Xevel/dynext/README.md

dynext
======

Dynamixel extension board.
