Xevel/dynext/hardware/README.txt

Dynext - universal dynamixel device
===================================

V1.0 - 2014/03/02
- 4 layers
- first manufactured board
- smaller power section
- added voltage ref
- cleaner separation of different voltages, and corresponding return path

v0.2 - unfinished, was too hard to route in 2 layers. The power section was nice though.

v0.1 - unfinished, was too hard to route in 2 layers
