Xevel/dynext/hardware/dynext_v2.1.brd

## EAGLE design hardware/dynext_v2.1.brd (2014-04-13)

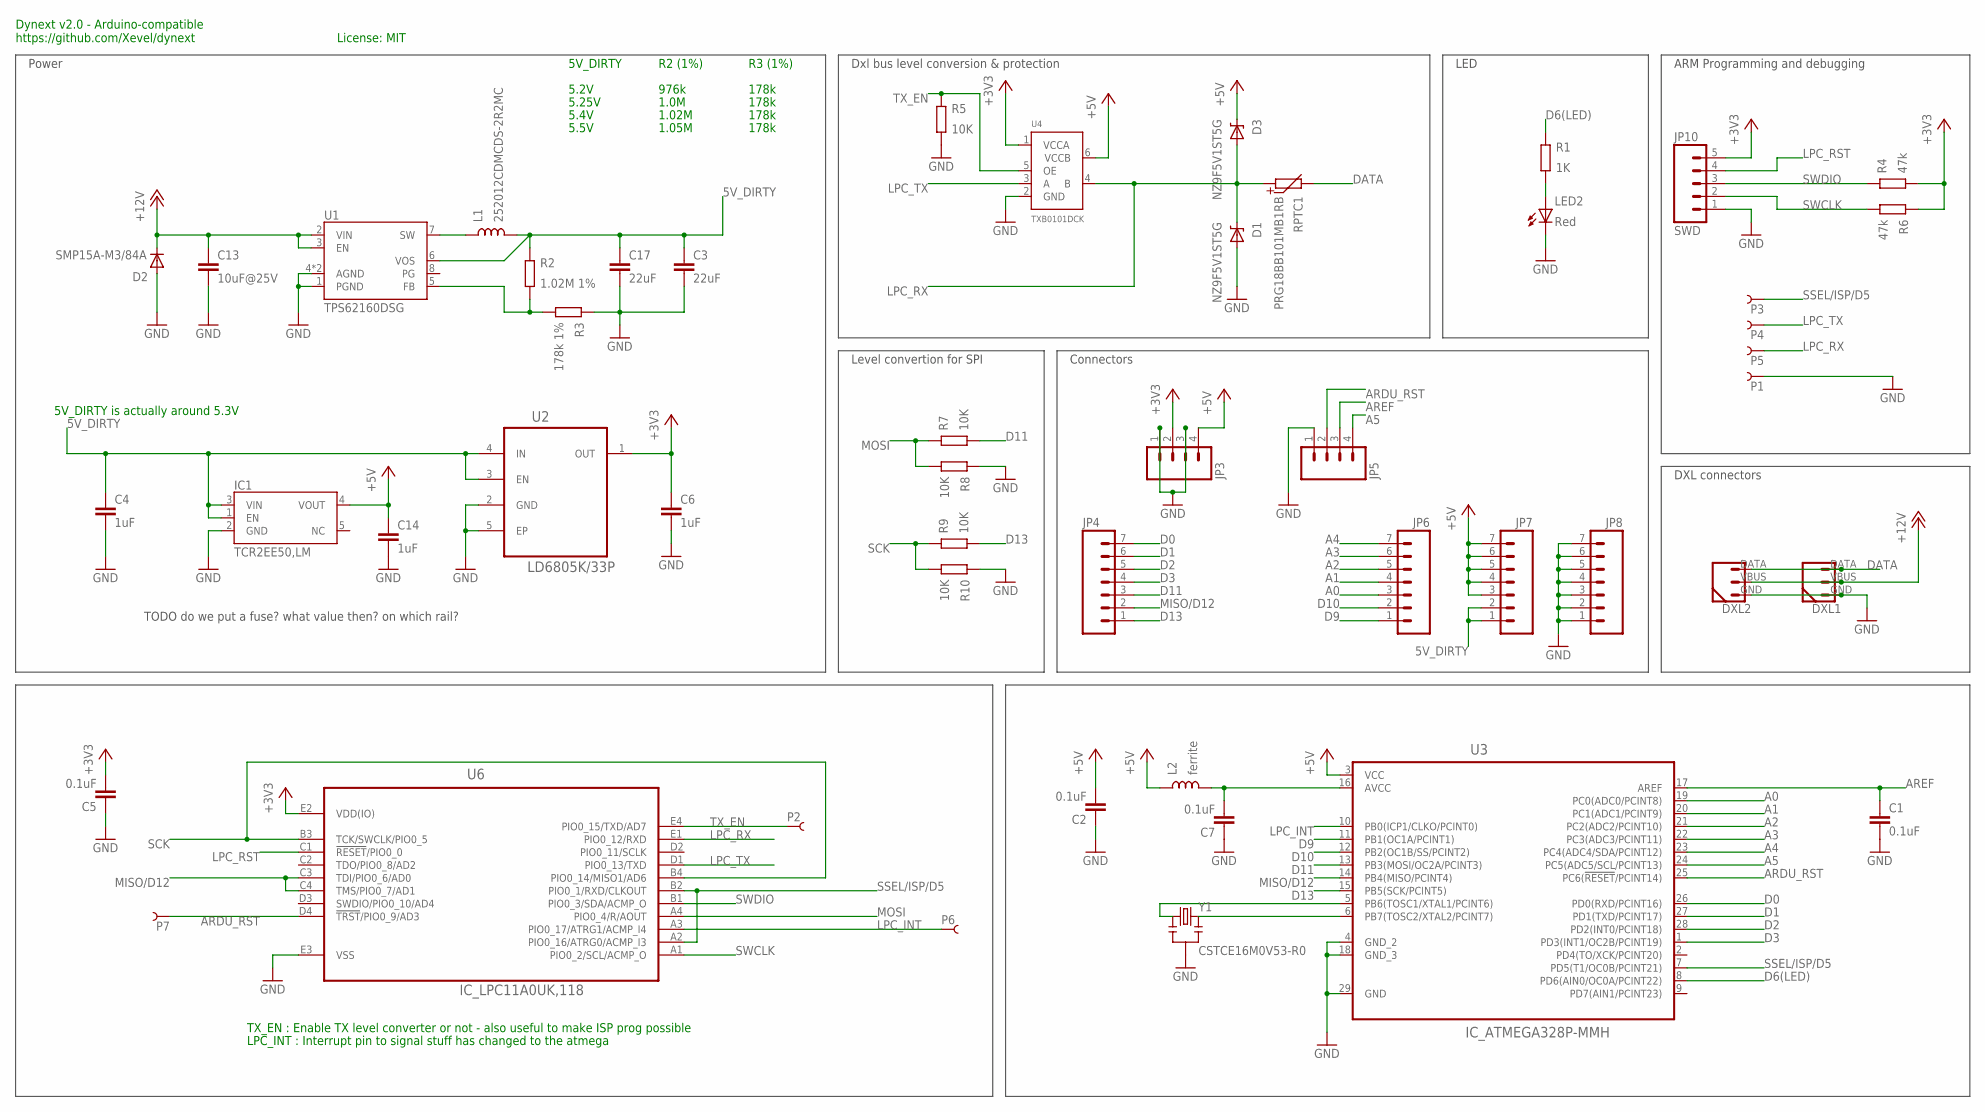
[picture p1: schematic dynext_v2.1.sch]

Parts:
C1, C2, C5, C7: 0.1uF; 0201_N
C3, C17: 22uF; 1206_N
C4, C6, C14: 1uF; 0402_N
C13: 10uF@25V; 0805_N
D1, D3: NZ9F5V1ST5G; SOD-923_N
D2: SMP15A-M3/84A; DO-220AA
DXL1, DXL2: DYNAMIXEL_3POS-R; DYNAMIXEL_3POS_RIGHT
IC1: TCR2EE50,LM; SOT50P160X60-5N
JP3, JP5: M041X04_NO_SILK; 1X04_NO_SILK
JP4, JP6, JP7: M07NO_SILK; 1X07_NO_SILK
JP8: M07SQUARE_ALL; 1X07_SQUARE_ALL
JP10: SWD; 1X05-1.27MM
L1: 252012CDMCDS-2R2MC; 1008_N
L2: ferrite; 0402_N
LED2: Red; D_0603_N
P1, P3, P4, P5: PIN_SMD_0.8X2
P2, P6, P7: PIN_SMD_1X1
R1: 1K; 0201_N
R2: 1.02M 1%; 0201_N
R3: 178k 1%; 0201_N
R4, R6: 47k; 0201_N
R5, R7, R8, R9, R10: 10K; 0201_N
RPTC1: PRG18BB101MB1RB; 0603_N
U1: TPS62160DSG; SON50P200X200X80-9L
U2: LD6805K/33P; NXP_LD6805
U3: IC_ATMEGA328P-MMH; QFN45P400X400X100-29N
U4: TXB0101DCK; SC70-6
U6: IC_LPC11A0UK,118; BGA20C50P_250X250X65
Y1: CSTCE16M0V53-R0; RESONATOR-SMD

Connections:
5V_DIRTY: C3.1, C4.1, C17.1, IC1.1 (EN), IC1.3 (VIN), JP7.1, JP7.2, L1.2, R2.2, U1.6 (VOS), U2.3 (EN), U2.4 (IN)
+3V3: C5.2, C6.1, JP3.2, JP10.5, R4.1, R6.2, U2.1 (OUT), U4.1 (VCCA), U6.E2 (VDD(IO))
+5V: C2.2, C14.1, D3.C, IC1.4 (VOUT), JP3.4, JP7.3, JP7.4, JP7.5, JP7.6, JP7.7, L2.1, U3.3 (VCC), U4.6 (VCCB)
+12V: C13.1, D2.C, DXL1.VBUS (2), DXL2.VBUS (2), U1.2 (VIN), U1.3 (EN)
A0: JP6.3, U3.19 (PC0(ADC0/PCINT8))
A1: JP6.4, U3.20 (PC1(ADC1/PCINT9))
A2: JP6.5, U3.21 (PC2(ADC2/PCINT10))
A3: JP6.6, U3.22 (PC3(ADC3/PCINT11))
A4: JP6.7, U3.23 (PC4(ADC4/SDA/PCINT12))
A5: JP5.4, U3.24 (PC5(ADC5/SCL/PCINT13))
ARDU_RST: JP5.2, P7.P$1, U3.25 (PC6(!RESET!/PCINT14)), U6.D4 (!TRST!/PIO0_9/AD3)
AREF: C1.1, JP5.3, U3.17 (AREF)
AVCC: C7.2, L2.2, U3.16 (AVCC)
D0: JP4.7, U3.26 (PD0(RXD/PCINT16))
D1: JP4.6, U3.27 (PD1(TXD/PCINT17))
D2: JP4.5, U3.28 (PD2(INT0/PCINT18))
D3: JP4.4, U3.1 (PD3(INT1/OC2B/PCINT19))
D6(LED): R1.2, U3.8 (PD6(AIN0/OC0A/PCINT22))
D9: JP6.1, U3.11 (PB1(OC1A/PCINT1))
D10: JP6.2, U3.12 (PB2(OC1B/SS/PCINT2))
D11: JP4.3, R7.1, U3.13 (PB3(MOSI/OC2A/PCINT3))
D13: JP4.1, R9.1, U3.15 (PB5(SCK/PCINT5))
DATA: DXL1.DATA (3), DXL2.DATA (3), RPTC1.2
GND: C1.2, C2.1, C3.2, C4.2, C5.1, C6.2, C7.1, C13.2, C14.2, C17.2, D1.A, D2.A, DXL1.GND (1), DXL2.GND (1), IC1.2 (GND), JP3.1, JP3.3, JP5.1, JP8.1, JP8.2, JP8.3, JP8.4, JP8.5, JP8.6, JP8.7, JP10.1, LED2.C, P1.PIN, R3.2, R5.1, R8.2, R10.2, U1.1 (PGND), U1.4 (AGND), U1.9 (AGND), U2.2 (GND), U2.5 (EP), U3.4 (GND_2), U3.18 (GND_3), U3.29 (GND), U4.2 (GND), U6.E3 (VSS), Y1.2
LPC_INT: P6.P$1, U3.10 (PB0(ICP1/CLKO/PCINT0)), U6.A3 (PIO0_17/ATRG1/ACMP_I4)
LPC_RST: JP10.4, U6.C1 (!RESET!/PIO0_0)
LPC_RX: D1.C, D3.A, P5.PIN, RPTC1.1, U4.4 (B), U6.E1 (PIO0_12/RXD)
LPC_TX: P4.PIN, U4.3 (A), U6.D1 (PIO0_13/TXD)
MISO/D12: JP4.2, U3.14 (PB4(MISO/PCINT4)), U6.C3 (TDI/PIO0_6/AD0), U6.C4 (TMS/PIO0_7/AD1)
MOSI: R7.2, R8.1, U6.A4 (PIO0_4/R/AOUT)
unnamed: L1.1, U1.7 (SW)
unnamed: LED2.A, R1.1
unnamed: U3.5 (PB6(TOSC1/XTAL1/PCINT6)), Y1.1
unnamed: U3.6 (PB7(TOSC2/XTAL2/PCINT7)), Y1.3
unnamed: R2.1, R3.1, U1.5 (FB)
SCK: R9.2, R10.1, U6.B3 (TCK/SWCLK/PIO0_5), U6.B4 (PIO0_14/MISO1/AD6)
SSEL/ISP/D5: P3.PIN, U3.7 (PD5(T1/OC0B/PCINT21)), U6.A2 (PIO0_16/ATRG0/ACMP_I3), U6.B2 (PIO0_1/RXD/CLKOUT)
SWCLK: JP10.2, R6.1, U6.A1 (PIO0_2/SCL/ACMP_O)
SWDIO: JP10.3, R4.2, U6.B1 (PIO0_3/SDA/ACMP_O)
TX_EN: P2.P$1, R5.2, U4.5 (OE), U6.E4 (PIO0_15/TXD/AD7)

Notes on the sheet:
DXL connectors
Power
ARM Programming and debugging
Dxl bus level conversion & protection
LED
Connectors
Dynext v2.0 - Arduino-compatible https://github.com/Xevel/dynext
License: MIT
LPC_INT : Interrupt pin to signal stuff has changed to the atmega
TX_EN : Enable TX level converter or not - also useful to make ISP prog possible
TODO do we put a fuse? what value then? on which rail?
Level convertion for SPI
5V_DIRTY is actually around 5.3V
R2 (1%)
R3 (1%)
5.2V
5.4V
5.25V
5.5V
976k
178k
1.0M
1.02M
1.05M
5V_DIRTY

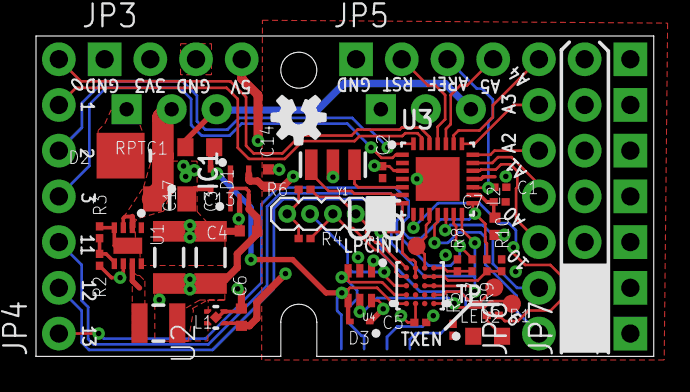
[picture p2: board dynext_v2.1.brd from above]

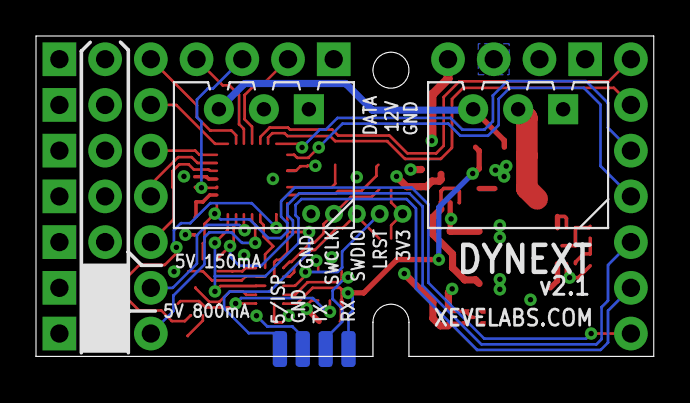
[picture p3: board dynext_v2.1.brd from below]

Board: 4 copper layers, 34.3 x 17.8 mm, 51 parts (6 on the bottom side), 40 nets.

Other parts of the board:
U$1: OSHW-LOGO-S
