Xevel/dynext/hardware/dynext_v1.1.brd

## EAGLE design hardware/dynext_v1.1.brd (2014-03-31, an earlier design)

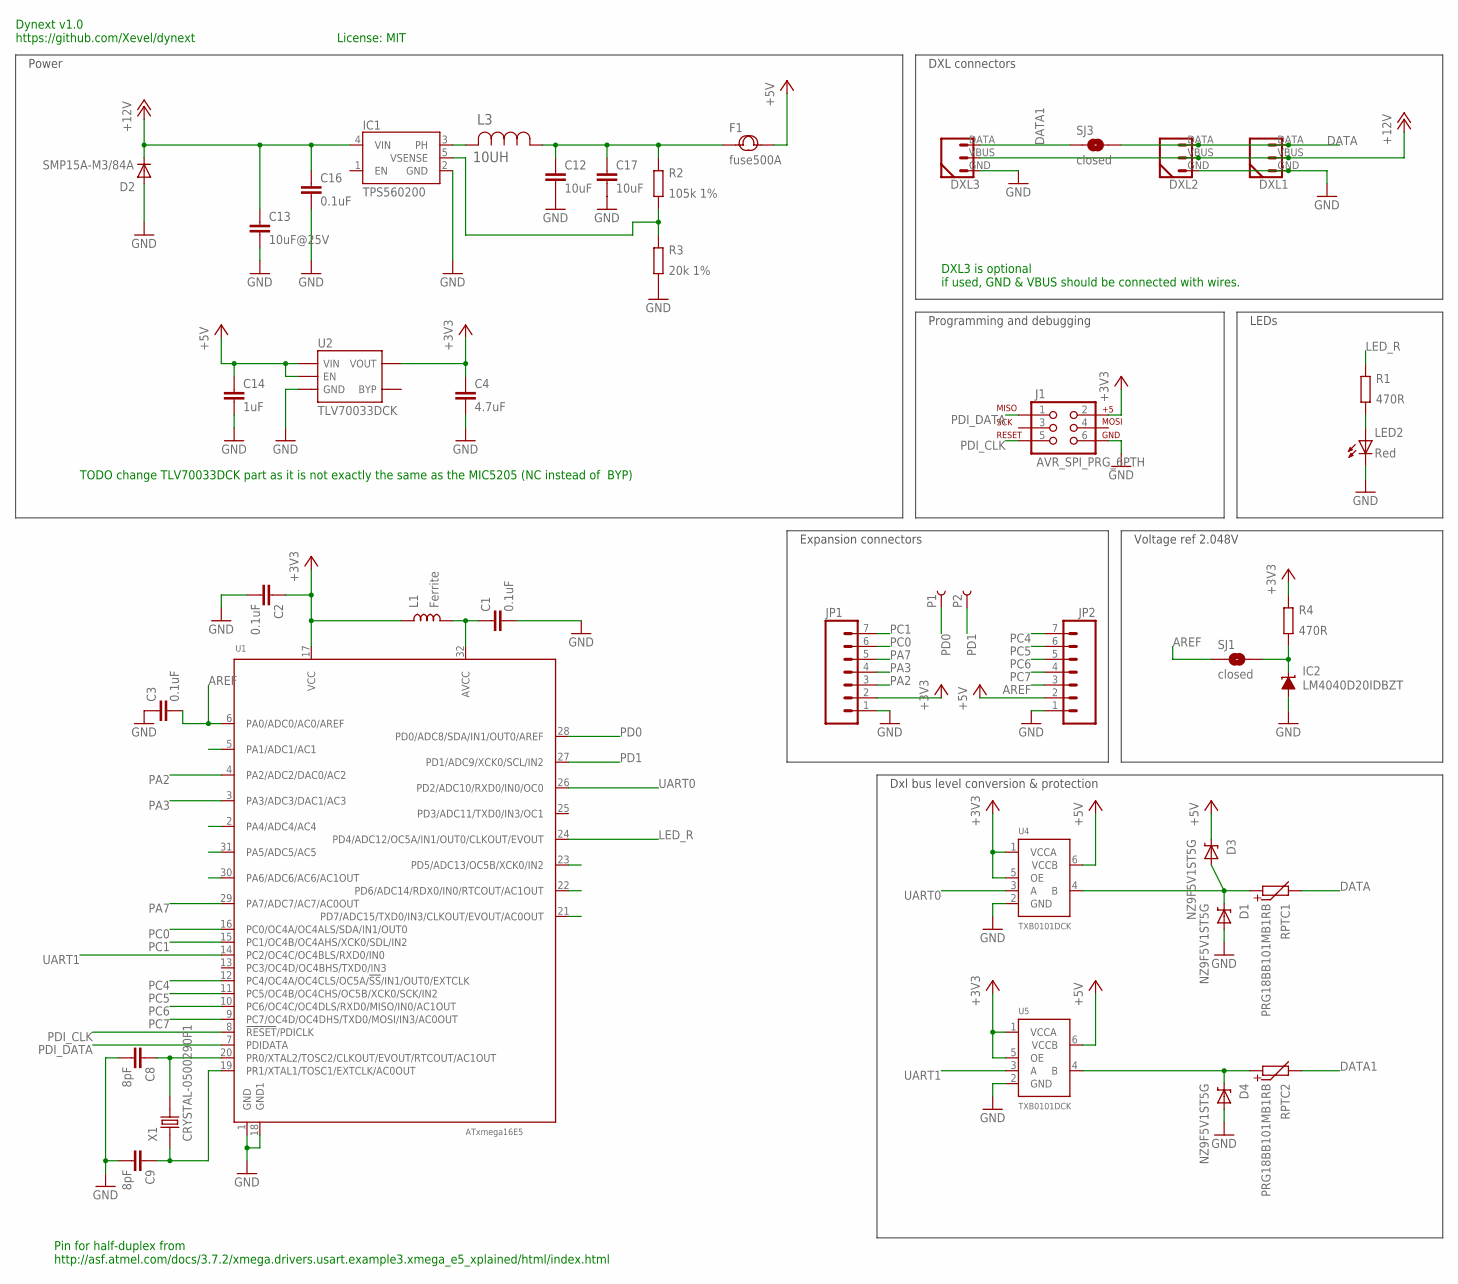
[picture p4: schematic dynext_v1.1.sch]

Parts:
C1, C2, C3, C16: 0.1uF; 0402_N
C4: 4.7uF; 0603_N
C8, C9: 8pF; 0402_N
C12, C17: 10uF; 0805_N
C13: 10uF@25V; 0805_N
C14: 1uF; 0402_N
D1, D3, D4: NZ9F5V1ST5G; SOD-923_N
D2: SMP15A-M3/84A; DO-220AA
DXL1, DXL2: DYNAMIXEL_3POS-T; DYNAMIXEL_3POS_TOP
DXL3: DYNAMIXEL_3POS-R; DYNAMIXEL_3POS_RIGHT
F1: fuse500A; F1206
IC1: TPS560200; SOT-23-5_N
IC2: LM4040D20IDBZT; DBZ_R-PDSO-G3
J1: AVR_SPI_PRG_6PTH; 2X3
JP1, JP2: M07; 1X07
L1: Ferrite; 0603_N
L3: 10UH; IND_ELL4XG
LED2: Red; D_0603_N
P1, P2: PIN_SMD_2X2.5
R1, R4: 470R; 0402_N
R2: 105k 1%; 0402_N
R3: 20k 1%; 0402_N
RPTC1, RPTC2: PRG18BB101MB1RB; 0603_N
SJ1, SJ3: closed; SJ_2S-TRACE2
U1: ATxmega16E5; QFN-32_50P_L_MOD
U2: TLV70033DCK; SC70-5
U4, U5: TXB0101DCK; SC70-6
X1: CRYSTAL-0500290P1; 2P-SMD-5.0X3.2

Connections:
+3V3: C2.1, C4.1, J1.2, JP1.2, L1.1, R4.2, U1.17 (VCC), U2.5 (VOUT), U4.1 (VCCA), U4.5 (OE), U5.1 (VCCA), U5.5 (OE)
+5V: C14.1, D3.C, F1.2, JP2.2, U2.1 (VIN), U2.3 (EN), U4.6 (VCCB), U5.6 (VCCB)
+12V: C13.1, C16.1, D2.C, DXL1.VBUS (2), DXL2.VBUS (2), DXL3.VBUS (2), IC1.4 (VIN)
AREF: C3.2, JP2.3, SJ1.1, U1.6 (PA0/ADC0/AC0/AREF)
DATA: DXL1.DATA (3), DXL2.DATA (3), RPTC1.2, SJ3.2
DATA1: DXL3.DATA (3), RPTC2.2, SJ3.1
GND: C1.2, C2.2, C3.1, C4.2, C8.2, C9.2, C12.2, C13.2, C14.2, C16.2, C17.2, D1.A, D2.A, D4.A, DXL1.GND (1), DXL2.GND (1), DXL3.GND (1), IC1.2 (GND), IC2.2 (A), J1.6, JP1.1, JP2.1, LED2.C, R3.1, U1.1 (GND), U1.18 (GND1), U2.2 (GND), U4.2 (GND), U5.2 (GND)
LED_R: R1.2, U1.24 (PD4/ADC12/OC5A/IN1/OUT0/CLKOUT/EVOUT)
unnamed: C1.1, L1.2, U1.32 (AVCC)
unnamed: LED2.A, R1.1
unnamed: C8.1, U1.20 (PR0/XTAL2/TOSC2/CLKOUT/EVOUT/RTCOUT/AC1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), X1.2
unnamed: C9.1, U1.19 (PR1/XTAL1/TOSC1/EXTCLK/AC0OUT), X1.1
unnamed: D1.C, D3.A, RPTC1.1, U4.4 (B)
unnamed: D4.C, RPTC2.1, U5.4 (B)
unnamed: C12.1, C17.1, F1.1, L3.1, R2.2
unnamed: IC1.5 (VSENSE), R2.1, R3.2
unnamed: IC2.1 (C), R4.1, SJ1.2
PA2: JP1.3, U1.4 (PA2/ADC2/DAC0/AC2)
PA3: JP1.4, U1.3 (PA3/ADC3/DAC1/AC3)
PA7: JP1.5, U1.29 (PA7/ADC7/AC7/AC0OUT)
PC0: JP1.6, U1.16 (PC0/OC4A/OC4ALS/SDA/IN1/OUT0)
PC1: JP1.7, U1.15 (PC1/OC4B/OC4AHS/XCK0/SDL/IN2)
PC4: JP2.7, U1.12 (PC4/OC4A/OC4CLS/OC5A/!SS!/IN1/OUT0/EXTC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)
PC5: JP2.6, U1.11 (PC5/OC4B/OC4CHS/OC5B/XCK0/SCK/IN2)
PC6: JP2.5, U1.10 (PC6/OC4C/OC4DLS/RXD0/MISO/IN0/AC1OUT)
PC7: JP2.4, U1.9 (PC7/OC4D/OC4DHS/TXD0/MOSI/IN3/AC0OUT)
PD0: P1.PIN, U1.28 (PD0/ADC8/SDA/IN1/OUT0/AREF)
PD1: P2.PIN, U1.27 (PD1/ADC9/XCK0/SCL/IN2)
PDI_CLK: J1.5, U1.8 (!RESET!/PDICLK)
PDI_DATA: J1.1, U1.7 (PDIDATA)
PH_L: IC1.3 (PH), L3.2
UART0: U1.26 (PD2/ADC10/RXD0/IN0/OC0), U4.3 (A)
UART1: U1.14 (PC2/OC4C/OC4BLS/RXD0/IN0), U5.3 (A)

Notes on the sheet:
DXL connectors
Power
Programming and debugging
Dxl bus level conversion & protection
LEDs
DXL3 is optional if used, GND & VBUS should be connected with wires.
Voltage ref 2.048V
TODO change TLV70033DCK part as it is not exactly the same as the MIC5205 (NC instead of BYP)
Pin for half-duplex from http://asf.atmel.com/docs/3.7.2/xmega.drivers.usart.example3.xmega_e5_xplained/html/index.html
Expansion connectors
Dynext v1.0 https://github.com/Xevel/dynext
License: MIT

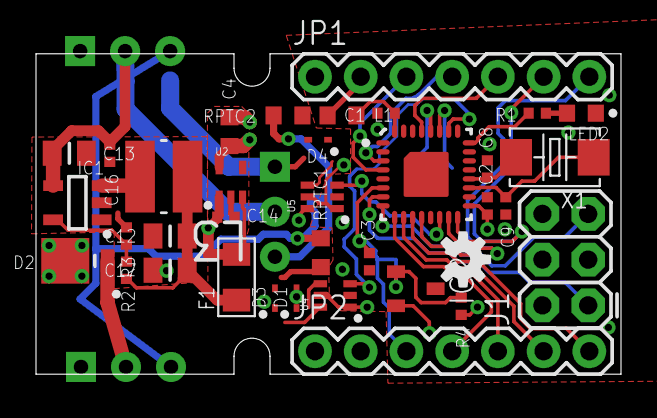
[picture p5: board dynext_v1.1.brd from above]

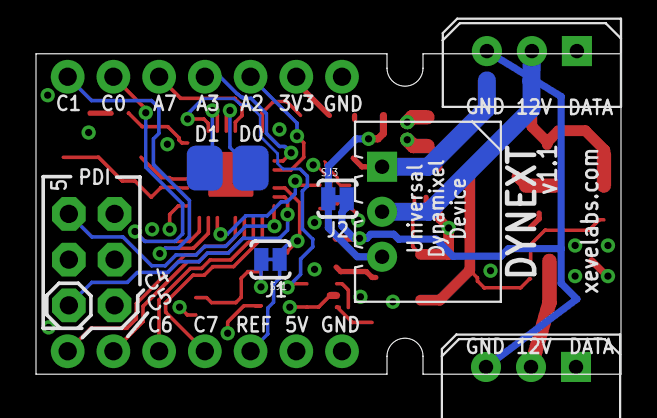
[picture p6: board dynext_v1.1.brd from below]

Board: 4 copper layers, 32.5 x 17.8 mm, 43 parts (5 on the bottom side), 33 nets.

Other parts of the board:
U$1: OSHW-LOGO-S
