Xevel/dynext/hardware/dynext_v0.1.brd

## EAGLE design hardware/dynext_v0.1.brd (2014-03-31, an earlier design)

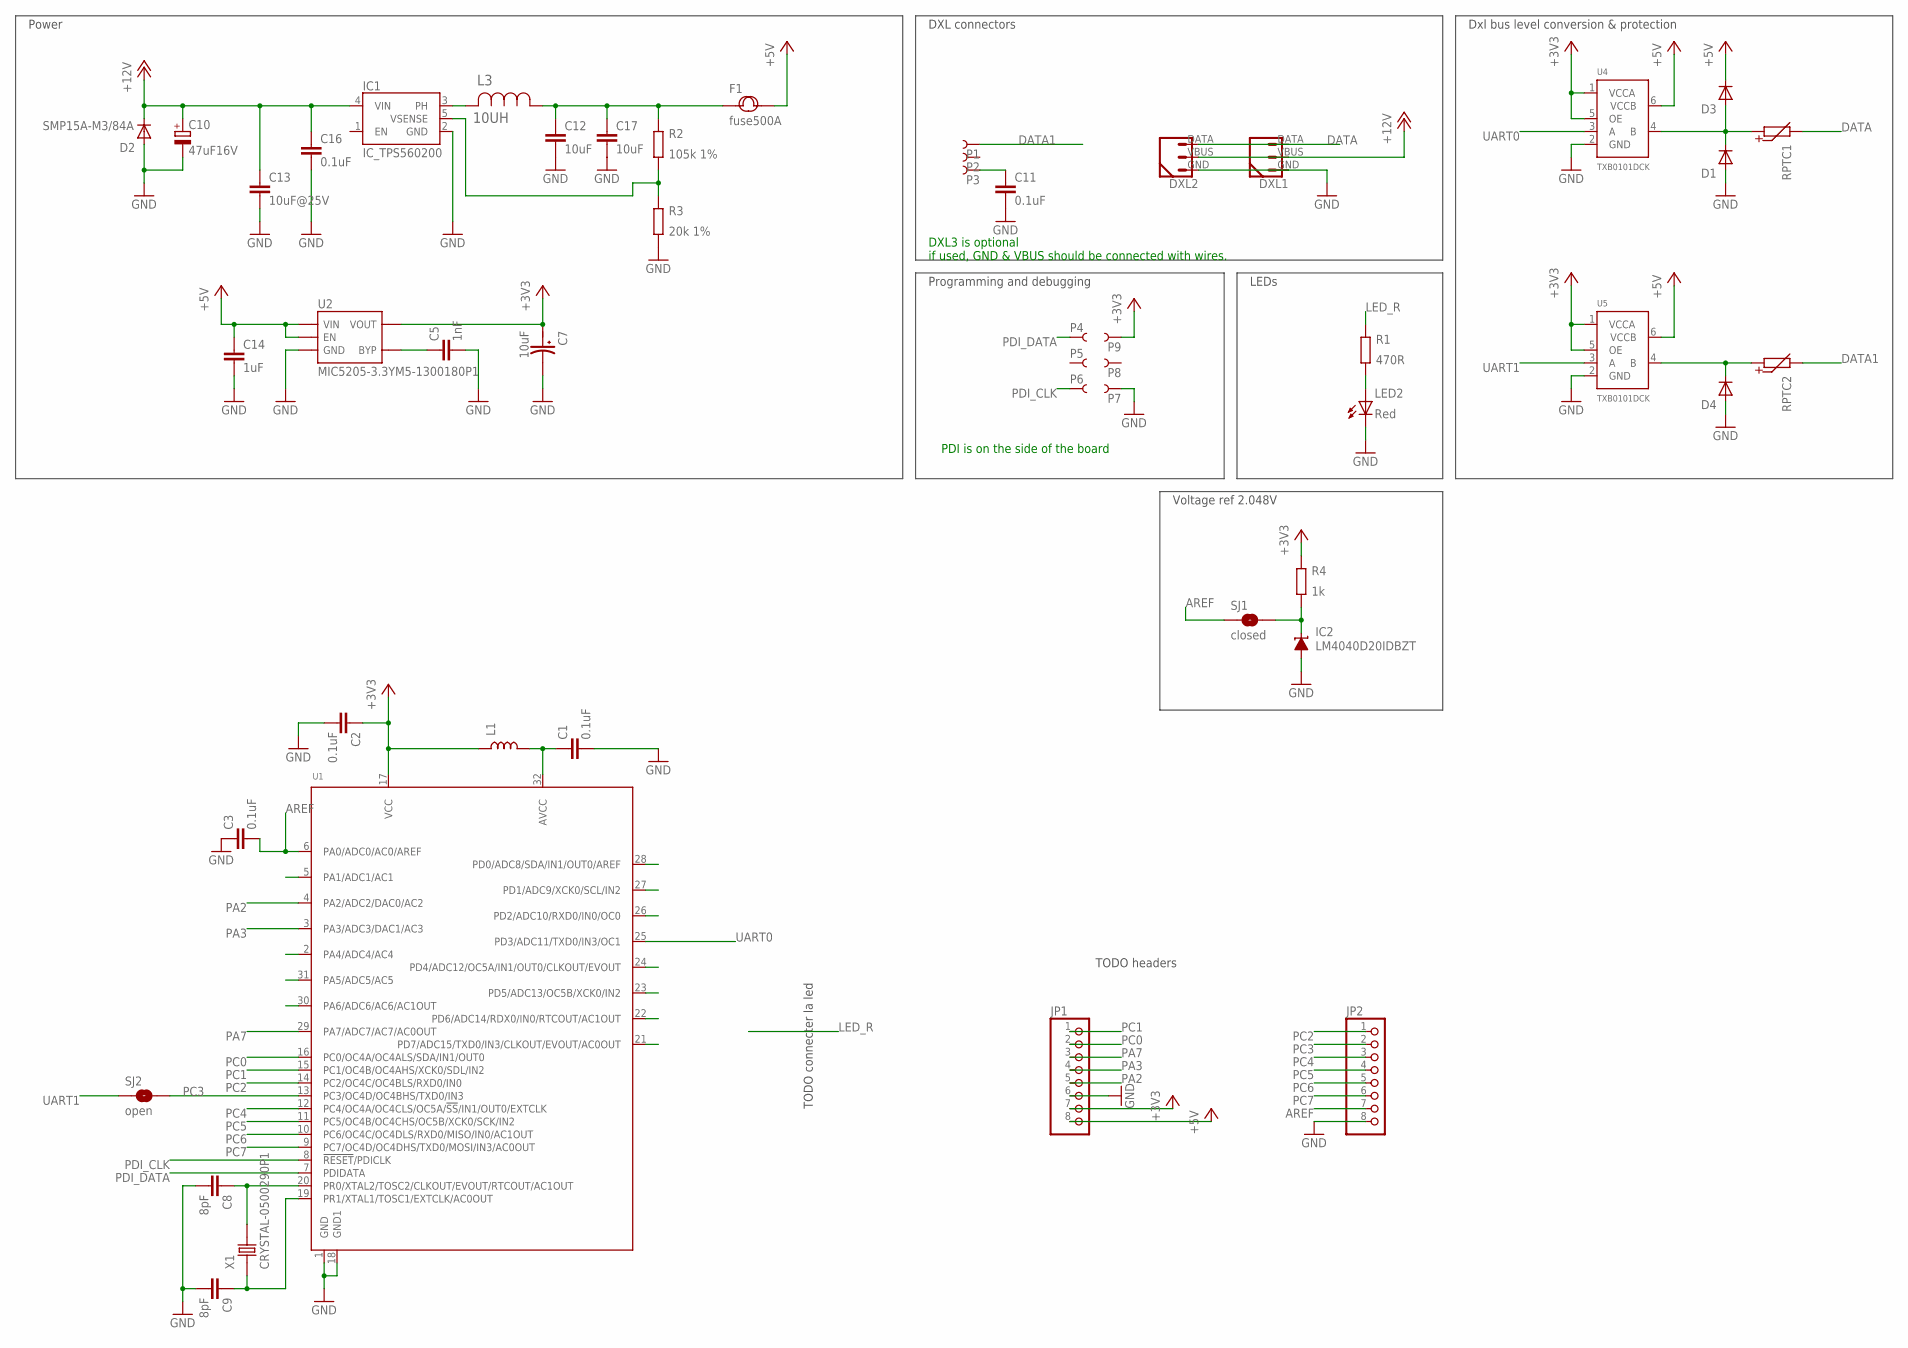
[picture p7: schematic dynext_v0.1.sch]

Parts:
C1, C2, C3, C11, C16: 0.1uF; 0402_N
C5: 1nF; 0402_N
C7: 10uF; AVX-A
C8, C9: 8pF; 0402_N
C10: 47uF16V; UD-5X5,8_NICHICON
C12, C17: 10uF; 0805_N
C13: 10uF@25V; 0805_N
C14: 1uF; 0402_N
D1, D3, D4: DIODE-SOD523; SOD-523_N
D2: SMP15A-M3/84A; DO-220AA
DXL1, DXL2: DYNAMIXEL_3POS-T; DYNAMIXEL_3POS_TOP
F1: fuse500A; F1206
IC1: IC_TPS560200; SOT-23-5_N
IC2: LM4040D20IDBZT; DBZ_R-PDSO-G3
JP1, JP2: PINHD-1X8R; 1X08_ROUND
L1: L0603; 0603_N
L3: 10UH; IND_ELL4XG
LED2: Red; D_0603_N
P1, P2, P3, P4, P6, P7, P9: PIN_SMD_2X2.5
P5, P8: PIN_SMD_1X1
R1: 470R; 0402_N
R2: 105k 1%; 0402_N
R3: 20k 1%; 0402_N
R4: 1k; 0402_N
RPTC1, RPTC2: R-PTC0603; 0603_N
SJ1: closed; SJ_2S-TRACE2
SJ2: open; SJ_2S-NO
U1: ATXMEGAE5-MU_MOD; QFN-32_50P_L_MOD
U2: MIC5205-3.3YM5-1300180P1; SOT23-5
U4, U5: TXB0101DCK; SC70-6
X1: CRYSTAL-0500290P1; 2P-SMD-5.0X3.2

Connections:
+3V3: C2.1, C7.+ (1), JP1.7, L1.1, P9.PIN, R4.2, U1.17 (VCC), U2.5 (VOUT), U4.1 (VCCA), U4.5 (OE), U5.1 (VCCA), U5.5 (OE)
+5V: C14.1, D3.C, F1.2, JP1.8, U2.1 (VIN), U2.3 (EN), U4.6 (VCCB), U5.6 (VCCB)
+12V: C10.+, C13.1, C16.1, D2.C, DXL1.VBUS (2), DXL2.VBUS (2), IC1.4 (VIN)
AREF: C3.2, JP2.7, SJ1.1, U1.6 (PA0/ADC0/AC0/AREF)
DATA: DXL1.DATA (3), DXL2.DATA (3), RPTC1.2
DATA1: P1.PIN, RPTC2.2
GND: C1.2, C2.2, C3.1, C5.2, C7.- (2), C8.2, C9.2, C10.-, C11.2, C12.2, C13.2, C14.2, C16.2, C17.2, D1.A, D2.A, D4.A, DXL1.GND (1), DXL2.GND (1), IC1.2 (GND), IC2.2 (A), JP1.6, JP2.8, LED2.C, P7.PIN, R3.1, U1.1 (GND), U1.18 (GND1), U2.2 (GND), U4.2 (GND), U5.2 (GND)
LED_R: R1.2
unnamed: C11.1, P3.PIN
unnamed: C1.1, L1.2, U1.32 (AVCC)
unnamed: LED2.A, R1.1
unnamed: C8.1, U1.20 (PR0/XTAL2/TOSC2/CLKOUT/EVOUT/RTCOUT/AC1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), X1.2
unnamed: C5.1, U2.4 (BYP)
unnamed: C9.1, U1.19 (PR1/XTAL1/TOSC1/EXTCLK/AC0OUT), X1.1
unnamed: D1.C, D3.A, RPTC1.1, U4.4 (B)
unnamed: D4.C, RPTC2.1, U5.4 (B)
unnamed: C12.1, C17.1, F1.1, L3.1, R2.2
unnamed: IC1.5 (VSENSE), R2.1, R3.2
unnamed: IC2.1 (C), R4.1, SJ1.2
PA2: JP1.5, U1.4 (PA2/ADC2/DAC0/AC2)
PA3: JP1.4, U1.3 (PA3/ADC3/DAC1/AC3)
PA7: JP1.3, U1.29 (PA7/ADC7/AC7/AC0OUT)
PC0: JP1.2, U1.16 (PC0/OC4A/OC4ALS/SDA/IN1/OUT0)
PC1: JP1.1, U1.15 (PC1/OC4B/OC4AHS/XCK0/SDL/IN2)
PC2: JP2.1, U1.14 (PC2/OC4C/OC4BLS/RXD0/IN0)
PC3: JP2.2, SJ2.2, U1.13 (PC3/OC4D/OC4BHS/TXD0/IN3)
PC4: JP2.3, U1.12 (PC4/OC4A/OC4CLS/OC5A/!SS!/IN1/OUT0/EXTC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)
PC5: JP2.4, U1.11 (PC5/OC4B/OC4CHS/OC5B/XCK0/SCK/IN2)
PC6: JP2.5, U1.10 (PC6/OC4C/OC4DLS/RXD0/MISO/IN0/AC1OUT)
PC7: JP2.6, U1.9 (PC7/OC4D/OC4DHS/TXD0/MOSI/IN3/AC0OUT)
PDI_CLK: P6.PIN, U1.8 (!RESET!/PDICLK)
PDI_DATA: P4.PIN, U1.7 (PDIDATA)
PH_L: IC1.3 (PH), L3.2
UART0: U1.25 (PD3/ADC11/TXD0/IN3/OC1), U4.3 (A)
UART1: SJ2.1, U5.3 (A)

Notes on the sheet:
DXL connectors
Power
PDI is on the side of the board
Programming and debugging
Dxl bus level conversion & protection
LEDs
DXL3 is optional if used, GND & VBUS should be connected with wires.
Voltage ref 2.048V
TODO connecter la led
TODO headers

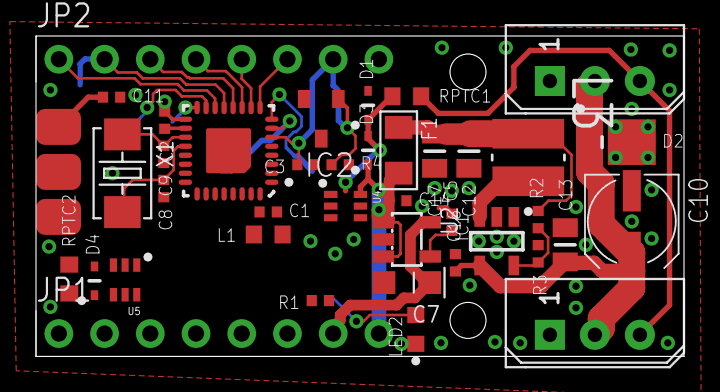
[picture p8: board dynext_v0.1.brd from above]

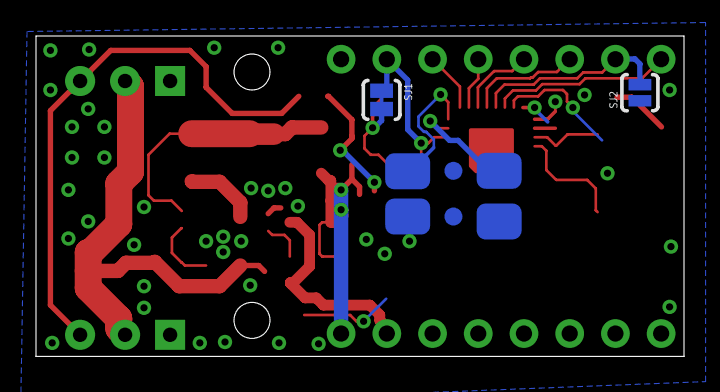
[picture p9: board dynext_v0.1.brd from below]

Board: 2 copper layers, 36.0 x 17.8 mm, 50 parts (8 on the bottom side), 34 nets.
