Xevel/dynext/(commit log)

2014-03-04 Import of the eagle files
    [dynext_v0.1.brd, dynext_v0.1.sch, dynext_v0.2.brd, dynext_v0.2.sch, dynext_v1.0.brd, dynext_v1.0.sch]
2014-03-04 Added license on schematics
    [dynext_v1.0.sch]
2014-03-06 Updated MCU footprint to avoid shitty manufacturing mistakes at board houses that remove polygones that have lines too small for their liking -_-
    [dynext_v0.1.brd, dynext_v0.1.sch, dynext_v0.2.brd, dynext_v0.2.sch, dynext_v1.0.brd, dynext_v1.0.sch]
2014-03-28 New Dynext architecture with Cortex-M0 + Arduino-compatible ATmega328p. WIP
    [dynext_v2.5.brd, dynext_v2.5.sch]
2014-03-28 Cleanup of versions of the board. Added semi-corrected version of v1, it I ever want to go back to it...
    [dynext_v1.1.brd, dynext_v1.1.sch, dynext_v2.0.brd, dynext_v2.0.sch]
2014-03-29 Shifting things around, preparing for the real pinout & layout.
    [dynext_v2.0.brd, dynext_v2.0.sch]
2014-03-30 Schematics stabilized, routing in half-way done.
    [dynext_v2.0.brd, dynext_v2.0.sch]
2014-03-30 Routing is getting close to something viable. I probably will rip up some of the most complex parts to simplifiy them ><
    [dynext_v2.0.brd, dynext_v2.0.sch]
2014-03-30 Routing roughly done and seems OK. More verif and silkscreen still needed.
    [dynext_v2.0.brd, dynext_v2.0.sch]
2014-03-30 Added all the silkscreen. Potentially ready.
    [dynext_v2.0.brd, dynext_v2.0.sch]
2014-03-31 Added some more silkscreen indications
    [dynext_v2.0.brd]
2014-03-31 Rearrangement of the schematics for better fitting on the screen
    [dynext_v2.0.sch]
2014-03-31 Some final minor tweaks. Board ordered.
    [dynext_v2.0.brd]
2014-04-01 Updated schematics with final values for the switch reg voltage divider.
    [dynext_v2.0.brd, dynext_v2.0.sch]
2014-04-01 Cosmetic details
    [dynext_v2.0.sch]
2014-04-13 beginingh of the V2.1 of the board created, with little corrections (missing connection, missing pull-down resistor). Not complete or routed yet.
    [dynext_v2.1.brd, dynext_v2.1.sch]
